makerMcl/alexaControlled/docs/ir_output_@irout_with-schottky_tn.jpg

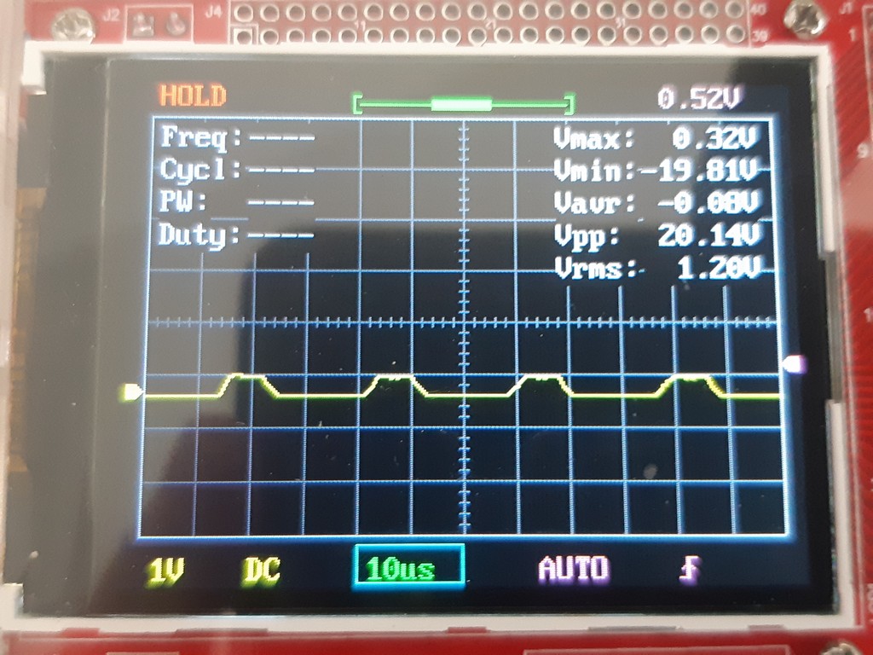
docs/ir_output_@irout_with-schottky_tn.jpg
