makerMcl/alexaControlled/docs/ir_output_@irout_wo-schottky_tn.jpg

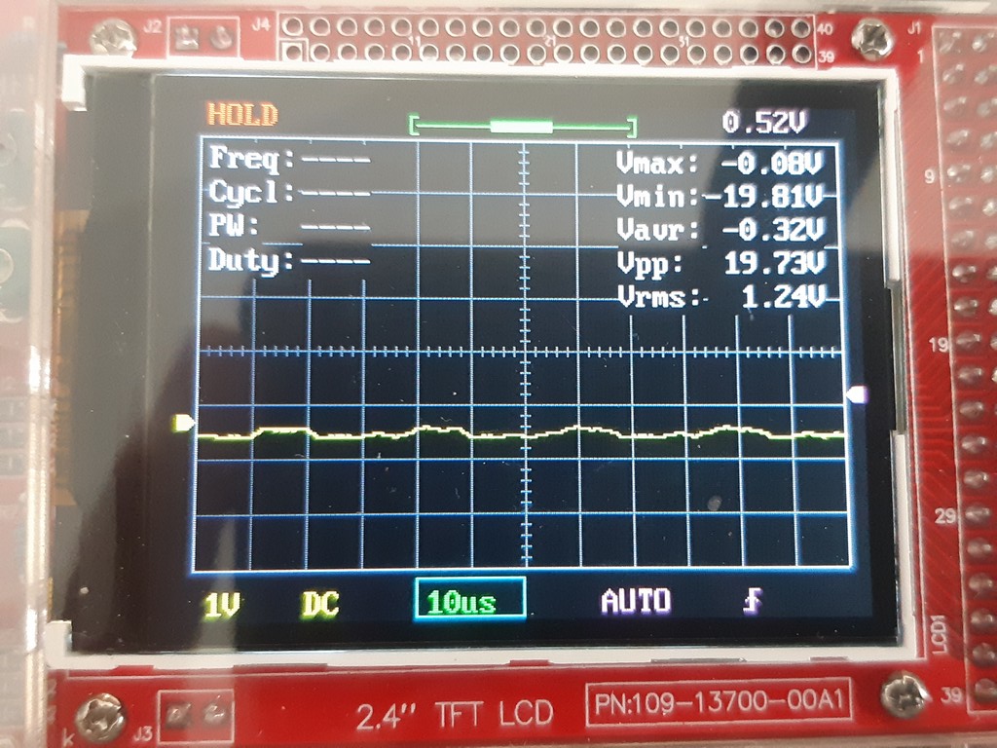
docs/ir_output_@irout_wo-schottky_tn.jpg
