makerMcl/alexaControlled/docs/ir_output_@outpin_with-schottky_tn.jpg

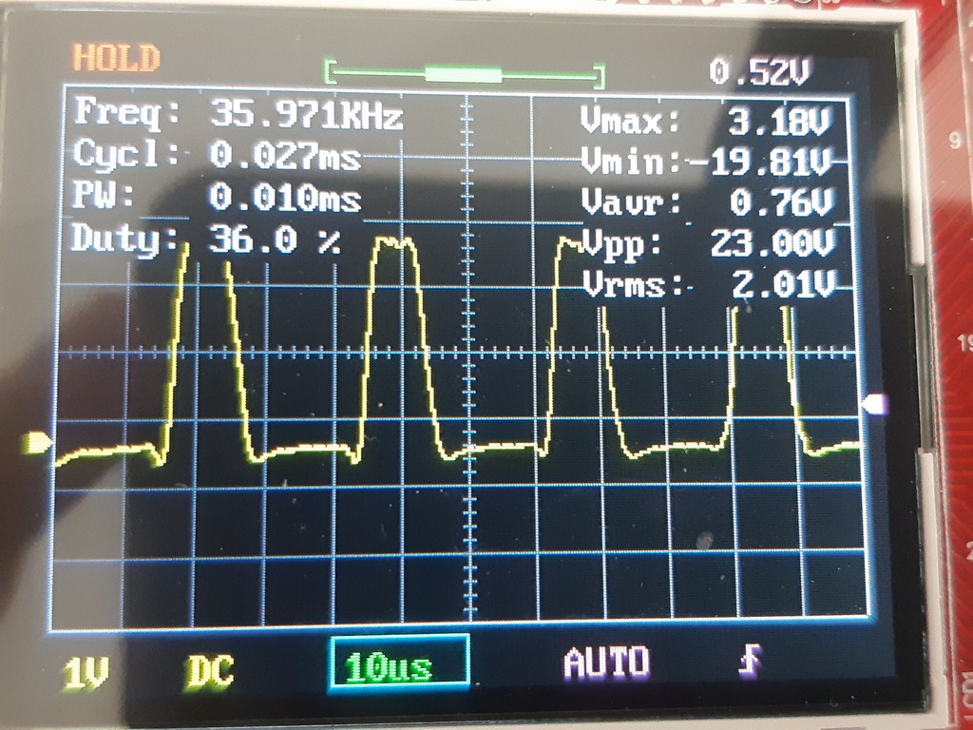
docs/ir_output_@outpin_with-schottky_tn.jpg
