makerMcl/alexaControlled/docs/ir_output_@outpin_wo-schottky_tn.jpg

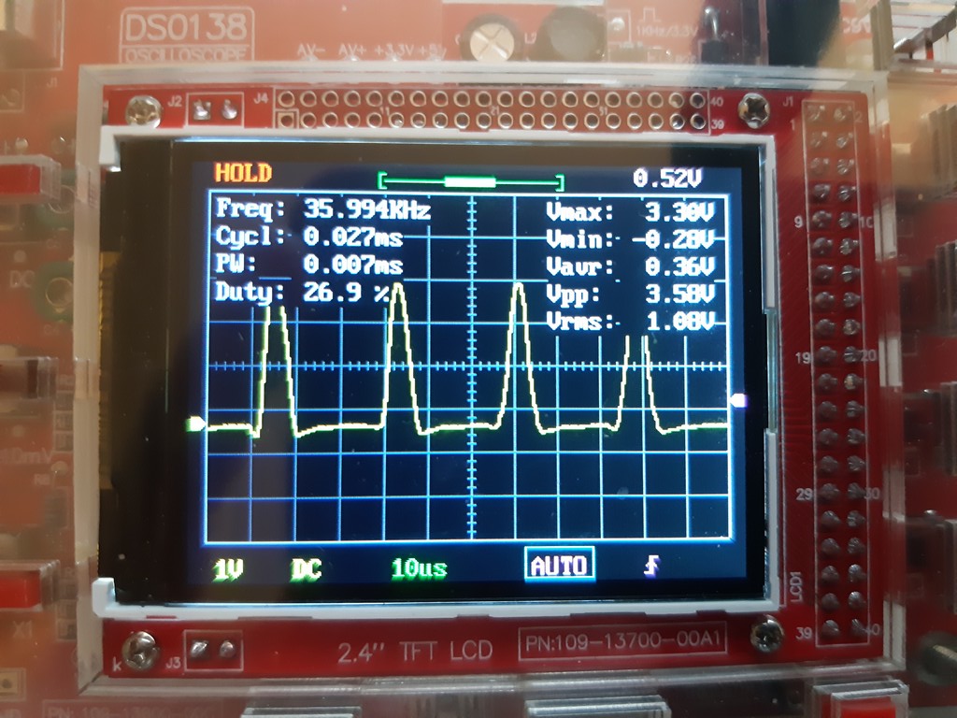
docs/ir_output_@outpin_wo-schottky_tn.jpg
