makerMcl/alexaControlled/docs/mmControl.pdf

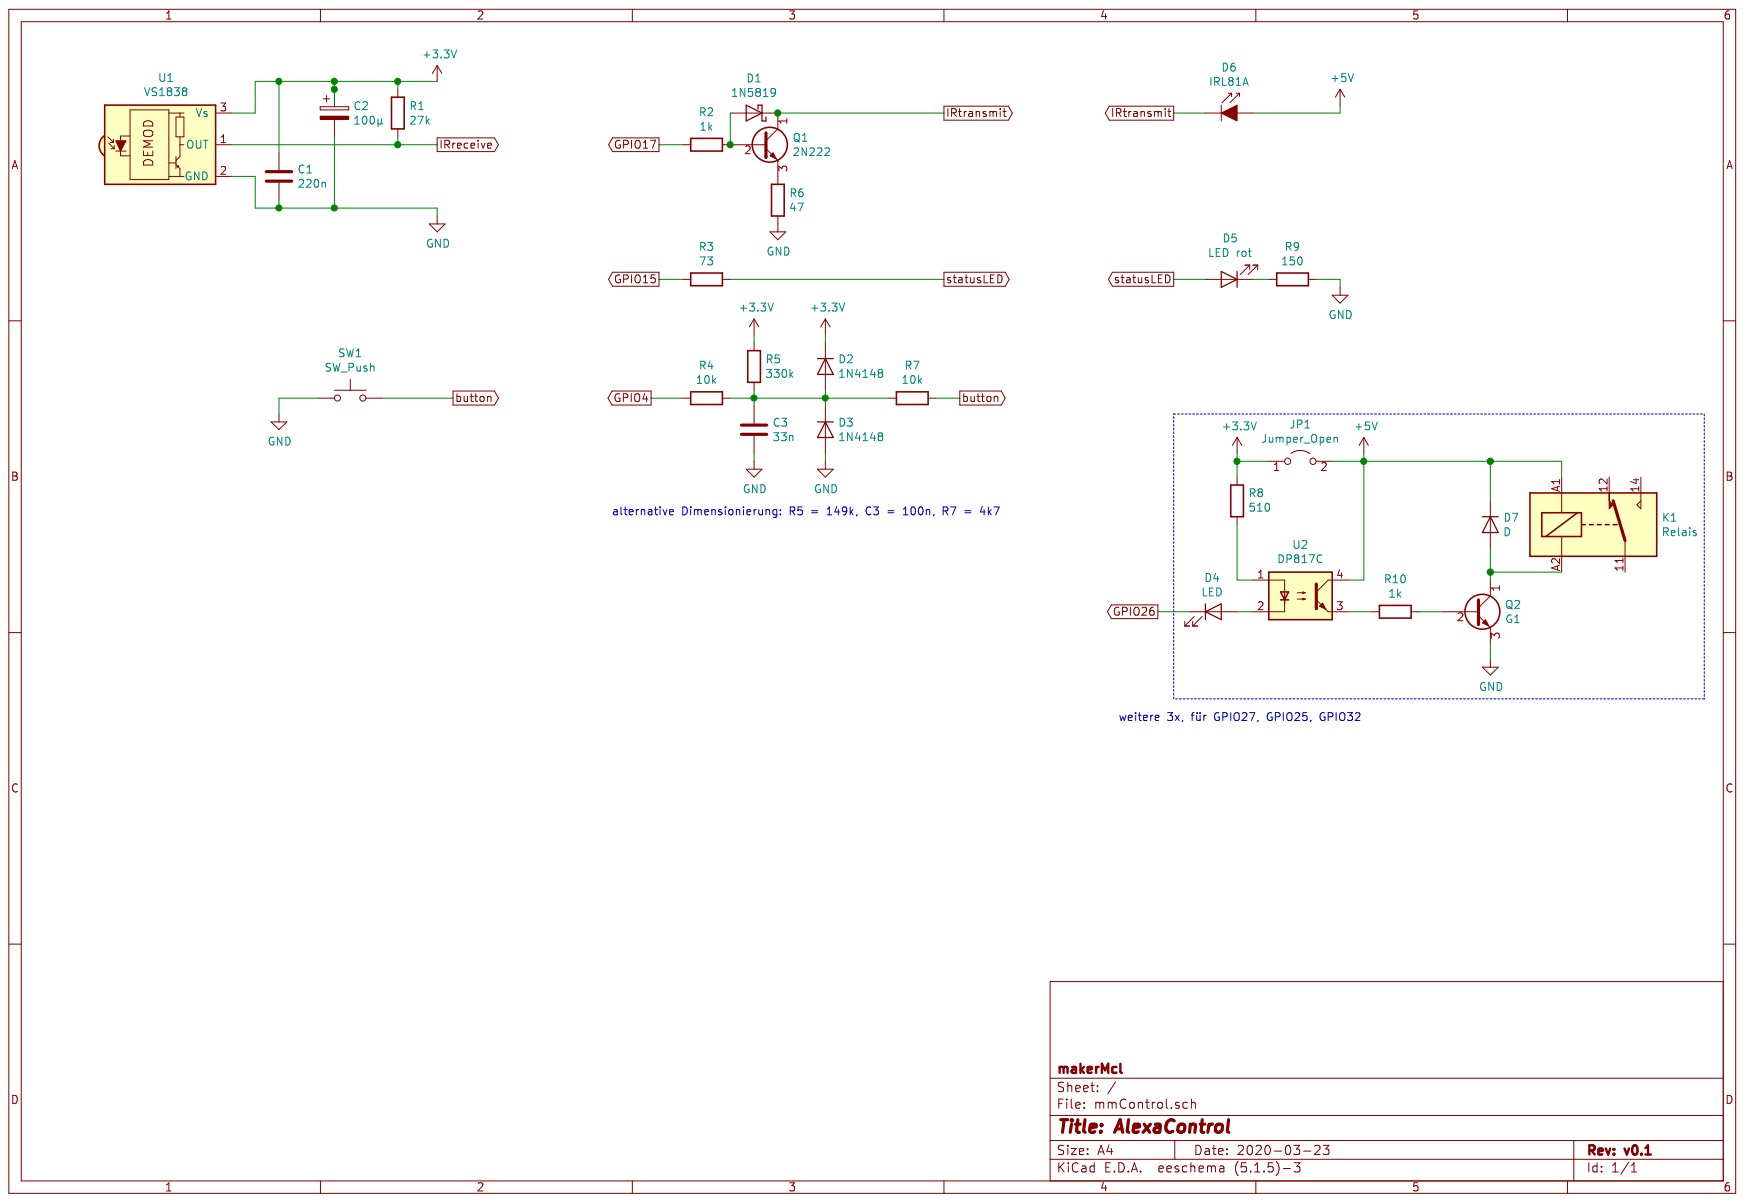
[picture p6: page 1]
