makerMcl/alexaControlled/docs/mmControl.sch

## KiCad design docs/mmControl.sch (2020-04-16)

Schematic: mmControl.sch

Parts:
C1: 220n
C2: 100µ
C3: 33n
D1: 1N5819
D2, D3: 1N4148
D4: LED
D5: LED rot
D6: IRL81A; LED_SideEmitter_Rectangular_W4.5mm_H1.6mm
D7: D
JP1: Jumper_Open
K1: Relais; Relay_SPST_Finder_32.21-x300
Q1: 2N222
Q2: G1
R1: 27k
R2, R10: 1k
R3: 64
R4, R7: 10k
R5: 330k
R6: 47
R8: 510
R9: 150
SW1: SW_Push
U1: VS1838; Vishay_MOLD-3Pin
U2: DP817C; DIP-4_W7.62mm

Notes on the sheet:
alternative Dimensionierung: R5 = 149k, C3 = 100n, R7 = 4k7
weitere 3x, für GPIO27, GPIO25, GPIO32
