makerMcl/alexaControlled/(commit log)

2020-03-24 initial commit, manual integration tests done
    [mmControl.sch]
2020-03-24 alternative values for the input protection circuit, documented helpful links
    [mmControl.sch]
2020-04-16 Recent work, integration tests fixed&done: * hint for circuit layout * using typesafe progmem string constants * fixed setting of is-state for channel and devices * adapted device ordering, adding al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
    [mmControl.sch]
